Curiosity2611/kicad_library/3D_Models/OSD32MP157C-512M-BAA.stp

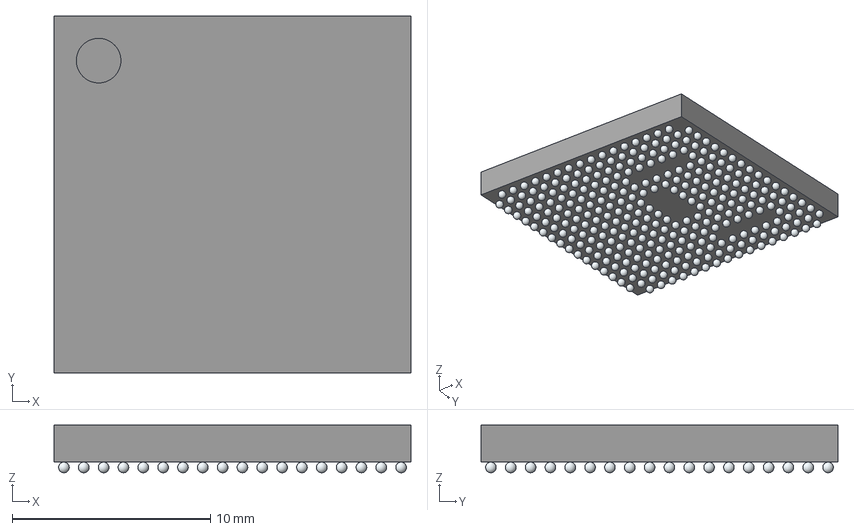
[picture p1: CAD file, 2021-05-24]
3D_Models/OSD32MP157C-512M-BAA.stp
18.0 x 18.0 x 2.40 mm
A2
A3
A4
A5
A6
A7
A8
A9
A10
A11
A12
A13
A14
A15
A16
A17
B1
B2
B3
B4
B5
B6
B7
B8
B9
B10
B11
B12
B13
B14
B15
B16
B17
B18
C1
C2
C3
C4
C5
C6
C7
C8
C9
C10
C11
C12
C13
C14
C15
C16
C17
C18
D1
D2
D3
D4
D5
D6
D7
D8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
