Curiosity2611/kicad_library/3D_Models/DF40C70DP04V51.stp

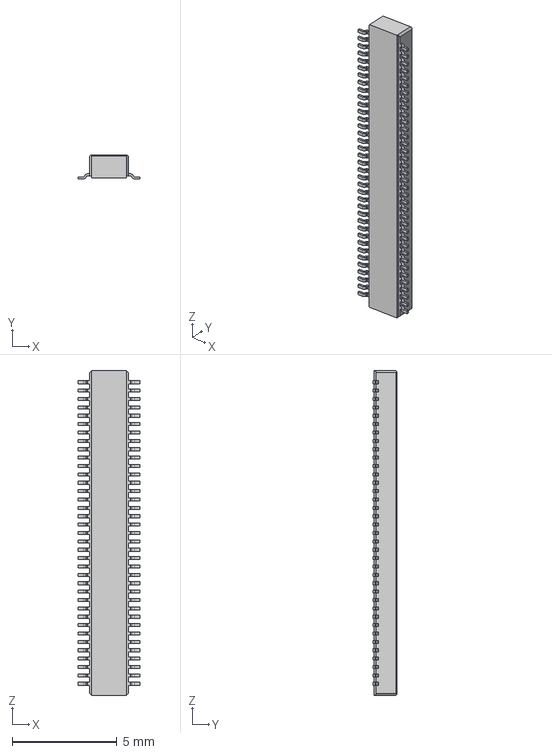
[picture p2: CAD file, 2021-05-24]
3D_Models/DF40C70DP04V51.stp
2.97 x 1.14 x 15.5 mm
