Curiosity2611/kicad_library/3D_Models/XTAL.stp

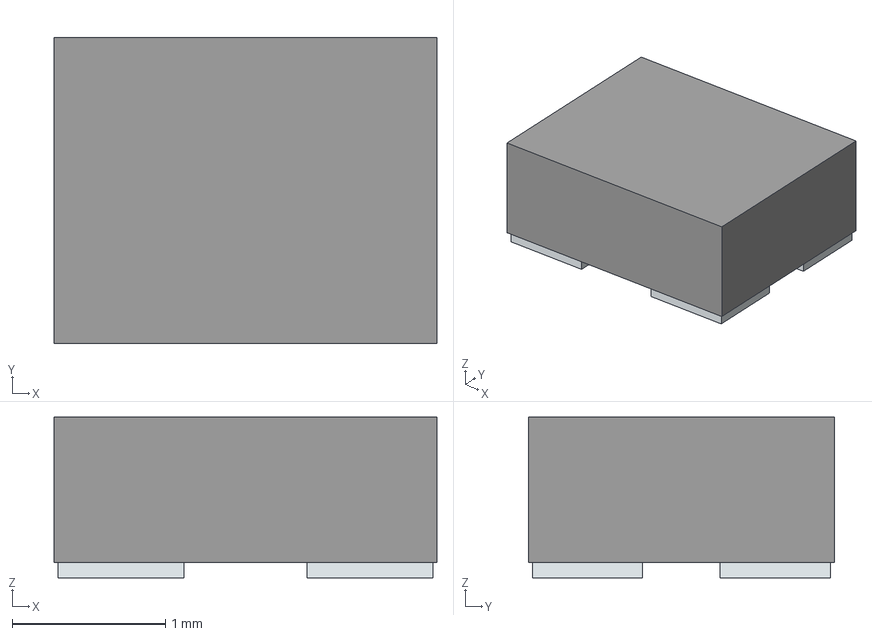
[picture p3: CAD file, 2021-05-24]
3D_Models/XTAL.stp
2.50 x 2.00 x 1.05 mm
Pins
