Curiosity2611/kicad_library/3D_Models/DF40C24DP04V51.stp

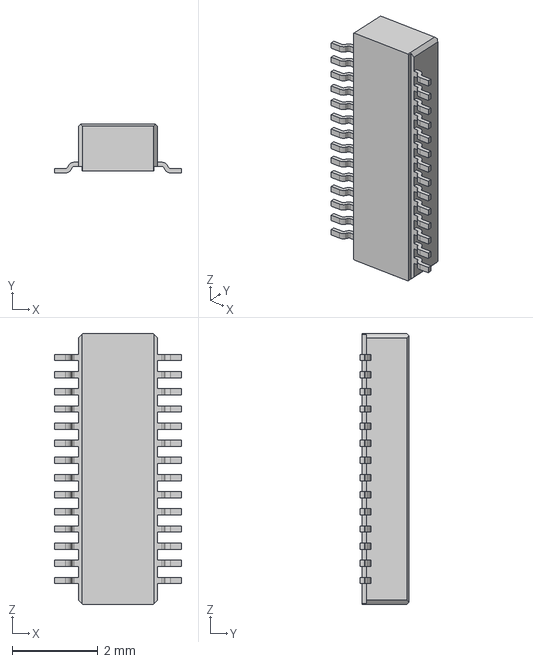
[picture p5: CAD file, 2021-05-24]
3D_Models/DF40C24DP04V51.stp
2.97 x 1.14 x 6.32 mm
