Curiosity2611/kicad_library/(commit log)

2021-05-24 re-initilized all libs
    [BGX220S22HNA21R.stp, DF40C24DP04V51.stp, DF40C70DP04V51.stp, OSD32MP157C-512M-BAA.stp, S40FC004C1B2C00000.stp, WFM200SS22XNA3R.stp, XTAL.stp]
2021-05-24 corrected stm32mp1 symbol
